Mrugen-Fichadia/Spider-Bot/3D Files/Long leg_Long leg v12_Component4_1_Body1.stl

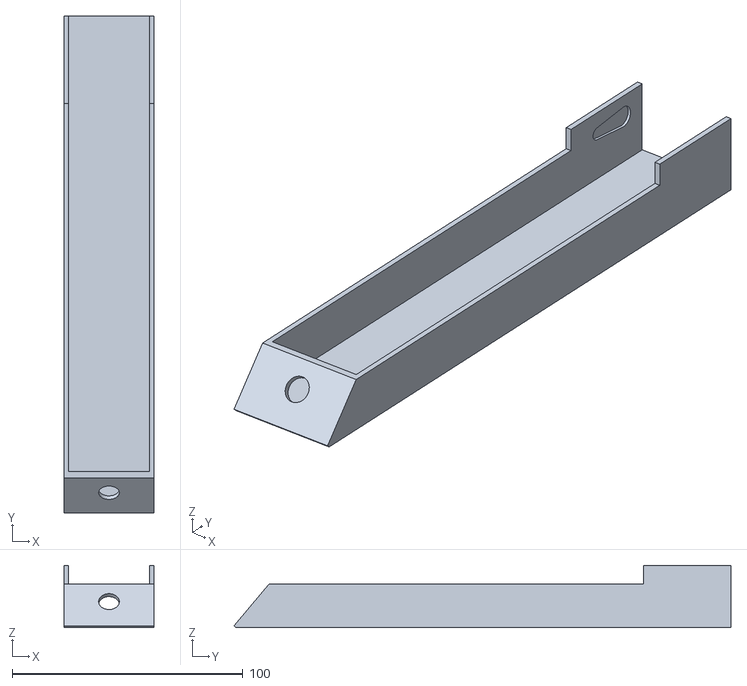
[picture p6: CAD file, 2022-12-23]
3D Files/Long leg_Long leg v12_Component4_1_Body1.stl
39.0 x 215.2 x 27.0
