Mrugen-Fichadia/Spider-Bot/3D Files/Long leg_Long leg v12_Component3_1_Body1.stl

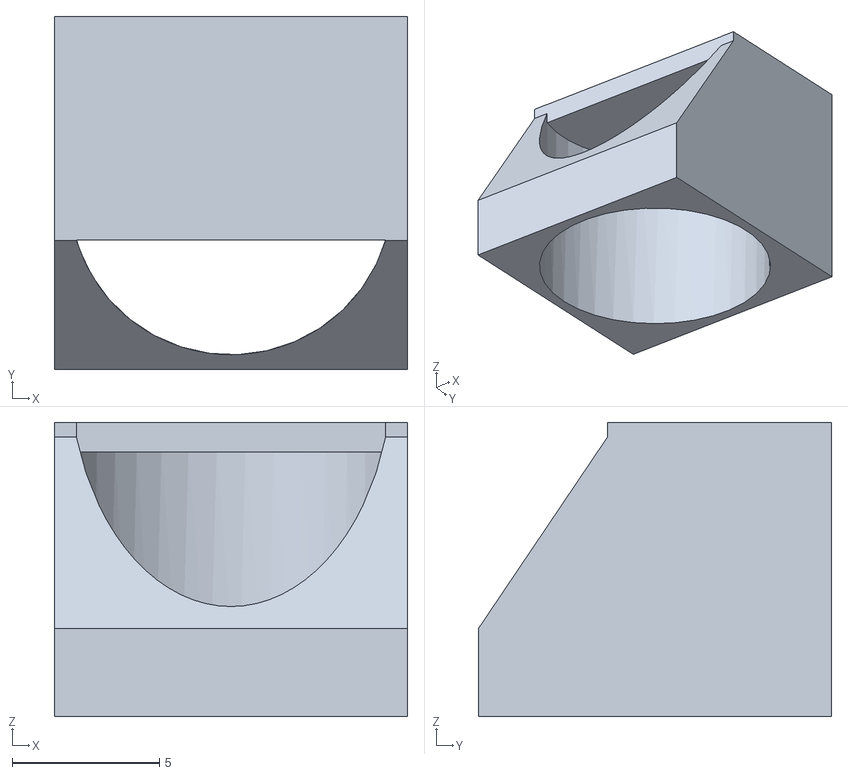
[picture p7: CAD file, 2022-12-23]
3D Files/Long leg_Long leg v12_Component3_1_Body1.stl
12.0 x 12.0 x 10.0
