Mrugen-Fichadia/Spider-Bot/3D Files/New leg connector_New leg connector v9_Body1.stl

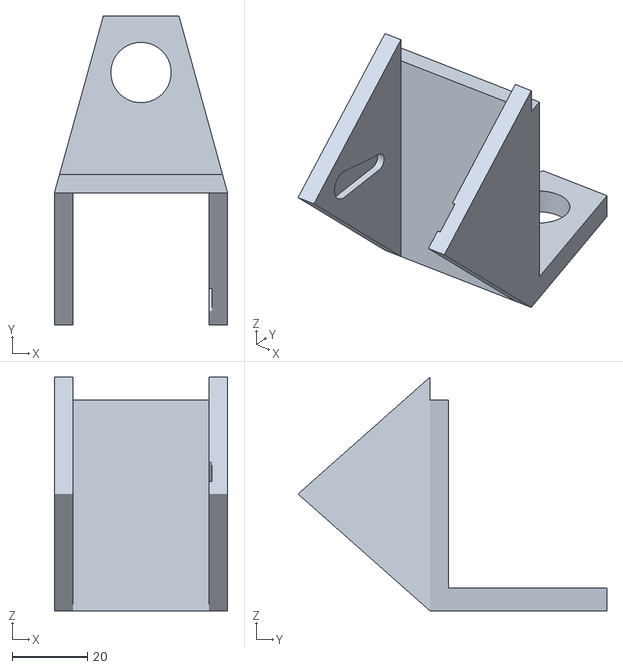
[picture p8: CAD file, 2022-12-23]
3D Files/New leg connector_New leg connector v9_Body1.stl
46.0 x 82.0 x 62.0
