Mrugen-Fichadia/Spider-Bot/3D Files/New leg connector_New leg connector v9_Cylinder_1_Cylinder.stl

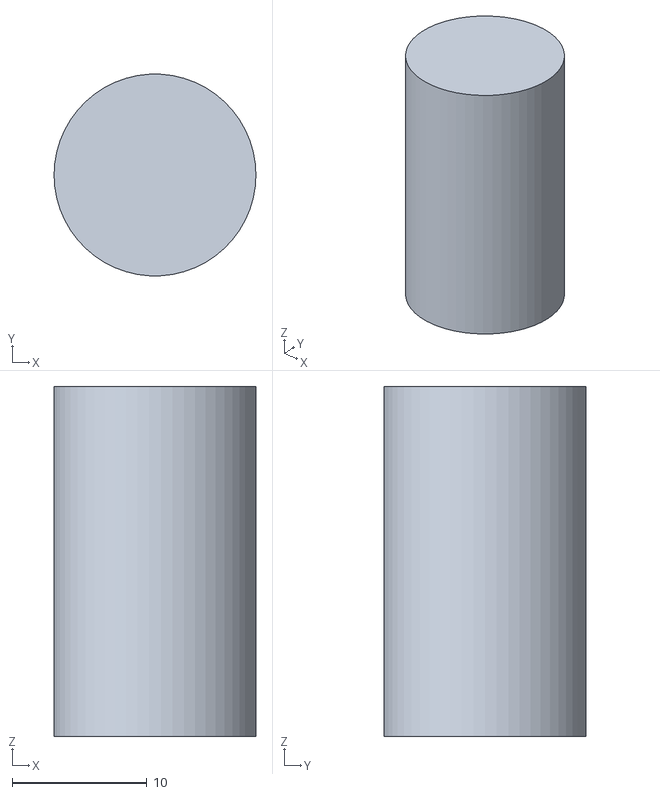
[picture p9: CAD file, 2022-12-23]
3D Files/New leg connector_New leg connector v9_Cylinder_1_Cylinder.stl
15.0 x 15.0 x 26.0
