Mrugen-Fichadia/Spider-Bot/3D Files/Base.stl

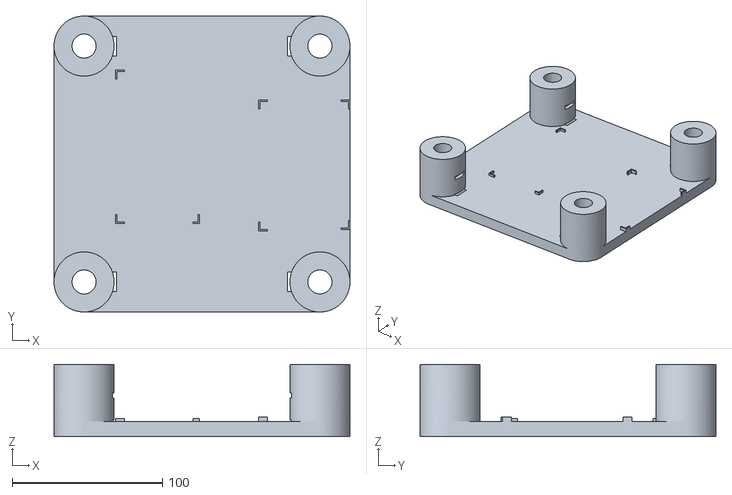
[picture p10: CAD file, 2022-12-23]
3D Files/Base.stl
197.0 x 197.0 x 48.0
