Mrugen-Fichadia/Spider-Bot/3D Files/New leg connector_New leg connector v9_Component1_1_Body1.stl

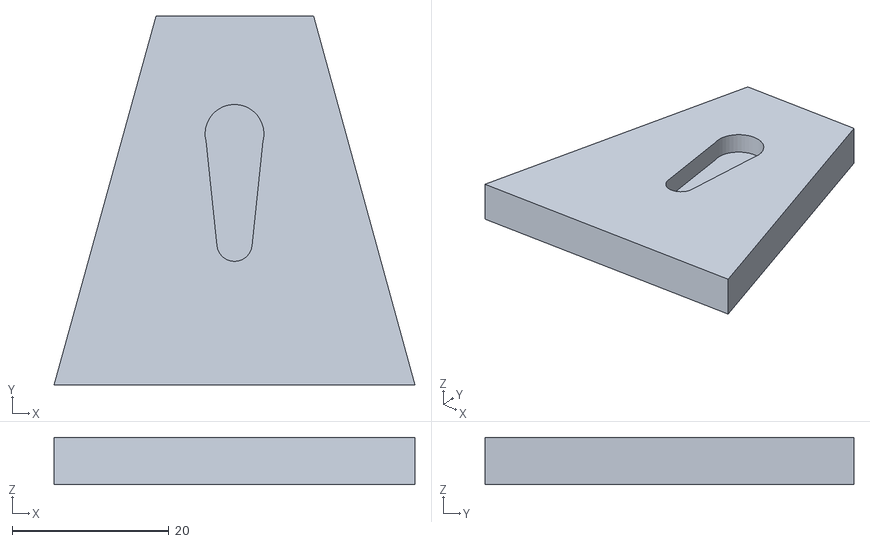
[picture p11: CAD file, 2022-12-23]
3D Files/New leg connector_New leg connector v9_Component1_1_Body1.stl
46.0 x 47.0 x 6.00
