Mrugen-Fichadia/Spider-Bot/3D Files/Long leg_Long leg v12_Body10.stl

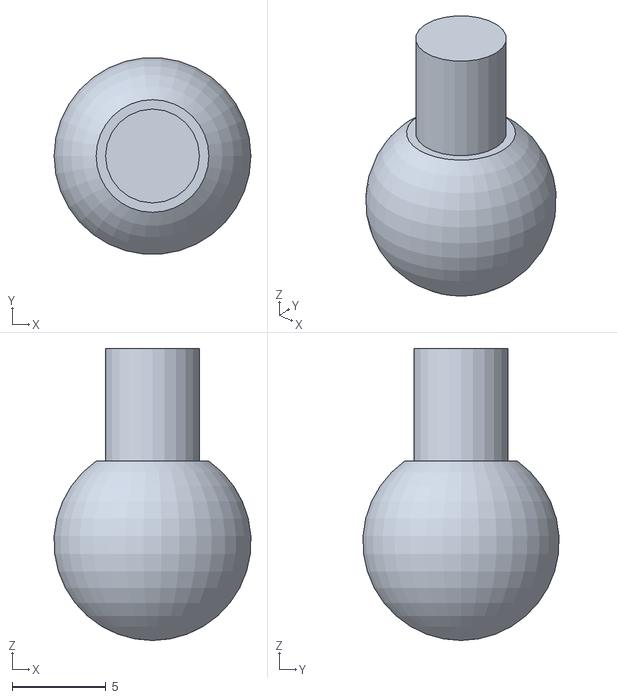
[picture p12: CAD file, 2022-12-23]
3D Files/Long leg_Long leg v12_Body10.stl
10.5 x 10.4 x 15.6
