Mrugen-Fichadia/Spider-Bot/3D Files/small leg.stl

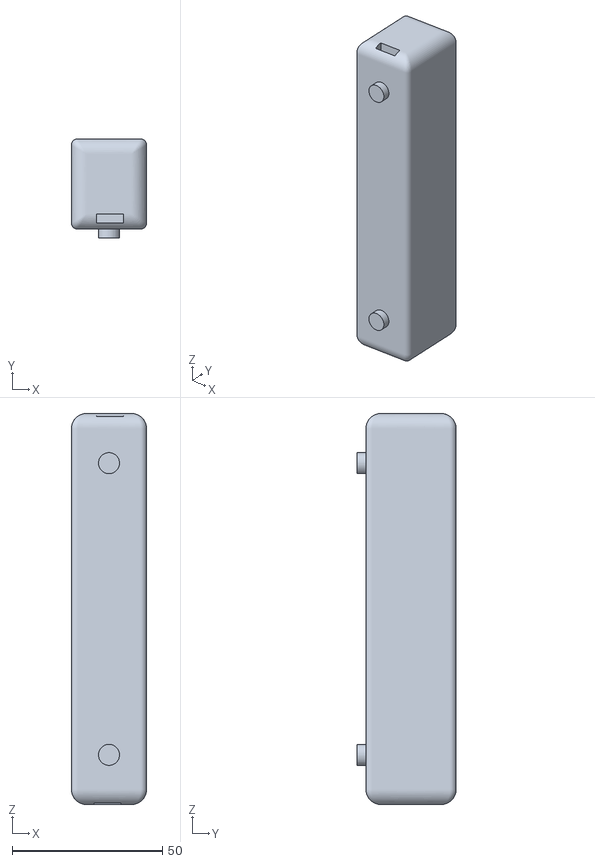
[picture p13: CAD file, 2022-12-23]
3D Files/small leg.stl
25.0 x 33.0 x 130.0
