Mrugen-Fichadia/Spider-Bot/(list of files, cad)

Other CAD files:
3D Files/Base.f3d
3D Files/Long leg.f3d
3D Files/New leg connector.f3d
3D Files/small leg.f3d
