Mrugen-Fichadia/Spider-Bot/Robo/Robo.ioc

Mcu.UserName=STM32F070RBTx
PA13.Signal=SYS_SWDIO
PA14.Signal=SYS_SWCLK
PA5.GPIO_Label=led
PA5.Signal=GPIO_Output
PA8.Signal=S_TIM1_CH1
PA9.Signal=GPIO_Output
PC7.Signal=GPIO_Output
PF0-OSC_IN.Signal=RCC_OSC_IN
PF1-OSC_OUT.Signal=RCC_OSC_OUT
